billyau615/GE1354_Design_Project/README.md

# Automated Drug Dispenser

An automated drug dispensing system built with Micro:bit, ESP32, and a web-based management interface. The system monitors environmental conditions, controls servo-driven dispensing mechanisms, and communicates via MQTT.

## System Overview

| Component | Role |
|---|---|
| **Micro:bit #1** | Main logic — DHT20 sensor, OLED display, passive buzzer, DS3231 RTC, UART to ESP32, radio to MB2 |
| **Micro:bit #2** | Servo motor control — receives dispense commands from MB1 via radio |
| **ESP32** | WiFi connectivity and MQTT communication |
| **Web Server** | Python backend serving the management UI, bridging MQTT |
| **MQTT Server** | Message broker between ESP32 and web server |

## Repository Structure

```
├── experiments/           # Standalone test projects for individual components
│   ├── oled-dht20/
│   ├── buzzer-rickroll/
│   ├── ir-sensor/
│   ├── ntp-clock/
│   │   ├── microbit/
│   │   └── esp32/
│   └── ds3231/
│       ├── microbit/
│       └── esp32/
├── microbit/main/         # Micro:bit integrated code
│   ├── mb1/               # Micro:bit #1 (main logic)
│   └── mb2/               # Micro:bit #2 (servo control)
├── esp32/main/            # ESP32 Arduino firmware
├── server/                # Python web server + MQTT bridge
└── docs/                  # Project documentation
```

## Documentation

- [System Architecture](docs/architecture.md)
- [Hardware & Wiring](docs/hardware.md)
- [Main Project Design](docs/main-project.md) — protocols, features, config checklist
- [Progress Report](docs/progress-report.md)

### Component Guides

- [Micro:bit #1](docs/mb1.md) — boot sequence, OLED layout, dispensing, schedules, UART/radio protocol
- [Micro:bit #2](docs/mb2.md) — servo control, radio protocol, refill flow, calibration
- [ESP32](docs/esp32.md) — WiFi/NTP setup, MQTT topics, UART relay, NVS persistence
- [Web UI](docs/web-ui.md) — dashboard, schedules page, settings page, real-time polling
- [Python Backend](docs/backend.md) — Flask routes, MQTT bridge, Telegram alerts, data flow

## Main Code

| File | Description |
|---|---|
| [microbit/main/mb1/main.py](microbit/main/mb1/main.py) | Micro:bit #1 — main dispenser logic |
| [microbit/main/mb2/main.py](microbit/main/mb2/main.py) | Micro:bit #2 — servo actuator |
| [esp32/main/main.ino](esp32/main/main.ino) | ESP32 — WiFi + NTP + MQTT + UART bridge |
| [server/app.py](server/app.py) | Web server — Flask routes |
| [server/mqtt_bridge.py](server/mqtt_bridge.py) | MQTT background thread |
| [server/telegram.py](server/telegram.py) | Telegram alert helper |

## Experiments

Small test projects to validate individual components before integration:

| Experiment | Description |
|---|---|
| [oled-dht20](experiments/oled-dht20/) | Read DHT20 temperature/humidity and display on OLED |
| [buzzer-rickroll](experiments/buzzer-rickroll/) | Play "Never Gonna Give You Up" on a passive buzzer |
| [ntp-clock](experiments/ntp-clock/) | Sync time from ESP32 NTP and display datetime on OLED, beep every minute |
| [ir-sensor](experiments/ir-sensor/) | FC-51 IR obstacle sensor on P1 triggers buzzer on P0 |
| [ds3231](experiments/ds3231/) | Fetch NTP time from ESP32 via UART, write to DS3231 RTC, display time from RTC on OLED |
| [servo-test](experiments/servo-test/) | Calibrate JX BLS-HV7146MG servo for 4-slot rotary pill dispenser (MB2) |
| [servo-cal](experiments/servo-cal/) | MQTT-driven per-slot pulse width calibration for both wheels, no reflashing needed |

## Web UI Demo

Interactive demo of the full web interface — open [demo.html](demo.html) directly in a browser, no server required. Includes editable dummy values for storage, sensor readings, countdown, and device status.
