billyau615/GE1354_Design_Project/microbit/for submission/mb1/oled.py

# AI
from microbit import i2c

OLED_ADDR = 0x3C

FONT = bytearray([
    0x00,0x00,0x00,0x00,0x00, 0x00,0x00,0x5F,0x00,0x00, 0x00,0x07,0x00,0x07,0x00,
    0x14,0x7F,0x14,0x7F,0x14, 0x24,0x2A,0x7F,0x2A,0x12, 0x23,0x13,0x08,0x64,0x62,
    0x36,0x49,0x55,0x22,0x50, 0x00,0x05,0x03,0x00,0x00, 0x00,0x1C,0x22,0x41,0x00,
    0x00,0x41,0x22,0x1C,0x00, 0x08,0x2A,0x1C,0x2A,0x08, 0x08,0x08,0x3E,0x08,0x08,
    0x00,0x50,0x30,0x00,0x00, 0x08,0x08,0x08,0x08,0x08, 0x00,0x60,0x60,0x00,0x00,
    0x20,0x10,0x08,0x04,0x02, 0x3E,0x51,0x49,0x45,0x3E, 0x00,0x42,0x7F,0x40,0x00,
    0x42,0x61,0x51,0x49,0x46, 0x21,0x41,0x45,0x4B,0x31, 0x18,0x14,0x12,0x7F,0x10,
    0x27,0x45,0x45,0x45,0x39, 0x3C,0x4A,0x49,0x49,0x30, 0x01,0x71,0x09,0x05,0x03,
    0x36,0x49,0x49,0x49,0x36, 0x06,0x49,0x49,0x29,0x1E, 0x00,0x36,0x36,0x00,0x00,
    0x00,0x56,0x36,0x00,0x00, 0x00,0x08,0x14,0x22,0x41, 0x14,0x14,0x14,0x14,0x14,
    0x41,0x22,0x14,0x08,0x00, 0x02,0x01,0x51,0x09,0x06, 0x32,0x49,0x79,0x41,0x3E,
    0x7E,0x11,0x11,0x11,0x7E, 0x7F,0x49,0x49,0x49,0x36, 0x3E,0x41,0x41,0x41,0x22,
    0x7F,0x41,0x41,0x22,0x1C, 0x7F,0x49,0x49,0x49,0x41, 0x7F,0x09,0x09,0x01,0x01,
    0x3E,0x41,0x41,0x51,0x32, 0x7F,0x08,0x08,0x08,0x7F, 0x00,0x41,0x7F,0x41,0x00,
    0x20,0x40,0x41,0x3F,0x01, 0x7F,0x08,0x14,0x22,0x41, 0x7F,0x40,0x40,0x40,0x40,
    0x7F,0x02,0x04,0x02,0x7F, 0x7F,0x04,0x08,0x10,0x7F, 0x3E,0x41,0x41,0x41,0x3E,
    0x7F,0x09,0x09,0x09,0x06, 0x3E,0x41,0x51,0x21,0x5E, 0x7F,0x09,0x19,0x29,0x46,
    0x46,0x49,0x49,0x49,0x31, 0x01,0x01,0x7F,0x01,0x01, 0x3F,0x40,0x40,0x40,0x3F,
    0x1F,0x20,0x40,0x20,0x1F, 0x7F,0x20,0x18,0x20,0x7F, 0x63,0x14,0x08,0x14,0x63,
    0x03,0x04,0x78,0x04,0x03, 0x61,0x51,0x49,0x45,0x43, 0x00,0x00,0x7F,0x41,0x41,
    0x02,0x04,0x08,0x10,0x20, 0x41,0x41,0x7F,0x00,0x00, 0x04,0x02,0x01,0x02,0x04,
    0x40,0x40,0x40,0x40,0x40, 0x00,0x01,0x02,0x04,0x00, 0x20,0x54,0x54,0x54,0x78,
    0x7F,0x48,0x44,0x44,0x38, 0x38,0x44,0x44,0x44,0x20, 0x38,0x44,0x44,0x48,0x7F,
    0x38,0x54,0x54,0x54,0x18, 0x08,0x7E,0x09,0x01,0x02, 0x08,0x54,0x54,0x54,0x3C,
    0x7F,0x08,0x04,0x04,0x78, 0x00,0x44,0x7D,0x40,0x00, 0x20,0x40,0x44,0x3D,0x00,
    0x00,0x7F,0x10,0x28,0x44, 0x00,0x41,0x7F,0x40,0x00, 0x7C,0x04,0x78,0x04,0x78,
    0x7C,0x08,0x04,0x04,0x78, 0x38,0x44,0x44,0x44,0x38, 0x7C,0x14,0x14,0x14,0x08,
    0x08,0x14,0x14,0x14,0x7C, 0x7C,0x08,0x04,0x04,0x08, 0x48,0x54,0x54,0x54,0x20,
    0x04,0x3F,0x44,0x40,0x20, 0x3C,0x40,0x40,0x40,0x3C, 0x1C,0x20,0x40,0x20,0x1C,
    0x3C,0x40,0x30,0x40,0x3C, 0x44,0x28,0x10,0x28,0x44, 0x0C,0x50,0x50,0x50,0x3C,
    0x44,0x64,0x54,0x4C,0x44, 0x00,0x08,0x36,0x41,0x00, 0x00,0x00,0x7F,0x00,0x00,
    0x00,0x41,0x36,0x08,0x00, 0x08,0x08,0x2A,0x1C,0x08,
])

def _cmd(*cmds):
    i2c.write(OLED_ADDR, b'\x00' + bytes(cmds))

def init_oled():
    _cmd(0xAE)
    _cmd(0xD5, 0x80)
    _cmd(0xA8, 0x3F)
    _cmd(0xD3, 0x00)
    _cmd(0x40)
    _cmd(0x8D, 0x14)
    _cmd(0x20, 0x00)
    _cmd(0xA1)
    _cmd(0xC8)
    _cmd(0xDA, 0x12)
    _cmd(0x81, 0xCF)
    _cmd(0xD9, 0xF1)
    _cmd(0xDB, 0x40)
    _cmd(0x2E)
    _cmd(0xA4)
    _cmd(0xA6)
    _cmd(0xAF)

def clear_oled():
    chunk = b'\x40' + b'\x00' * 16
    for page in range(8):
        _cmd(0x22, page, page)
        _cmd(0x21, 0, 127)
        for _ in range(8):
            i2c.write(OLED_ADDR, chunk)

def _scale_nibble(nibble):
    result = 0
    for i in range(4):
        bit = (nibble >> i) & 1
        result |= (bit << (i * 2))
        result |= (bit << (i * 2 + 1))
    return result

def write_oled_large(text, start_page):
    top_data = bytearray(128)
    bot_data = bytearray(128)
    col = 0
    for char in text:
        if col + 10 > 128:
            break
        idx = ord(char) - 32
        if 0 <= idx < 95:
            for j in range(5):
                byte = FONT[idx * 5 + j]
                top = _scale_nibble(byte & 0x0F)
                bot = _scale_nibble((byte >> 4) & 0x0F)
                top_data[col + j * 2]     = top
                top_data[col + j * 2 + 1] = top
                bot_data[col + j * 2]     = bot
                bot_data[col + j * 2 + 1] = bot
        col += 12
    _cmd(0x22, start_page, start_page)
    _cmd(0x21, 0, 127)
    i2c.write(OLED_ADDR, b'\x40' + bytes(top_data))
    _cmd(0x22, start_page + 1, start_page + 1)
    _cmd(0x21, 0, 127)
    i2c.write(OLED_ADDR, b'\x40' + bytes(bot_data))

def write_oled(text, line):
    _cmd(0x22, line, line)
    _cmd(0x21, 0, 127)
    data = bytearray(128)
    col = 0
    for char in text:
        if col + 5 > 128:
            break
        idx = ord(char) - 32
        if 0 <= idx < 95:
            for j in range(5):
                data[col + j] = FONT[idx * 5 + j]
        col += 6
    i2c.write(OLED_ADDR, b'\x40' + bytes(data))
