billyau615/GE1354_Design_Project/experiments/ntp-clock/esp32/ntp_clock.ino

// NTP Clock — syncs time once on boot and sends HH:MM:SS to Micro:bit.
// Micro:bit then runs the clock independently.
//
// Wiring:
//   ESP32 GPIO17 (RX) ← Micro:bit P16 (TX)
//   ESP32 GPIO16 (TX) → Micro:bit P8  (RX)

#include <WiFi.h>
#include <time.h>

// ── User configuration ──────────────────────────────────────────────────────
const char* WIFI_SSID    = "YOUR_WIFI_SSID";
const char* WIFI_PASS    = "YOUR_WIFI_PASSWORD";
const char* NTP_SERVER   = "pool.ntp.org";
const long  GMT_OFFSET   = 8 * 3600;   // UTC+8 (Hong Kong)
const int   DST_OFFSET   = 0;

// ── Pin configuration ───────────────────────────────────────────────────────
#define MB_RX_PIN 17   // receives from Micro:bit P16
#define MB_TX_PIN 16   // sends to Micro:bit P8

void setup() {
    Serial.begin(115200);
    Serial1.begin(9600, SERIAL_8N1, MB_RX_PIN, MB_TX_PIN);

    Serial.print("Connecting to WiFi");
    WiFi.begin(WIFI_SSID, WIFI_PASS);
    while (WiFi.status() != WL_CONNECTED) {
        delay(500);
        Serial.print(".");
    }
    Serial.println(" connected");

    configTime(GMT_OFFSET, DST_OFFSET, NTP_SERVER);

    // Wait for NTP sync
    struct tm timeinfo;
    Serial.print("Syncing NTP");
    while (!getLocalTime(&timeinfo)) {
        delay(500);
        Serial.print(".");
    }
    Serial.println(" synced");

}

void loop() {
    // Keep sending time every second — Micro:bit takes the first valid line
    // and ignores the rest once its own clock is running
    struct tm timeinfo;
    if (!getLocalTime(&timeinfo)) {
        delay(1000);
        return;
    }

    char buf[9];
    strftime(buf, sizeof(buf), "%H:%M:%S", &timeinfo);
    Serial1.println(buf);
    Serial.println(buf);

    delay(1000);
}
