billyau615/GE1354_Design_Project/(commit log)

2026-03-29 Reorganize repo structure and add documentation
    - Move micro:bit experiments into microbit/experiments/ subfolders
    - Add system architecture and hardware docs
    - Add placeholder READMEs for esp32/ and server/
    - Rewrite README with project overview and repo structure guide
    - Add .gitignore for .DS_Store and .claude/
2026-03-29 Update architecture: UART for all inter-device comms, ESP32 is MQTT bridge only
2026-03-29 Fix bytearray slice assignment not supported in MicroPython
    [oled.py]
2026-03-29 Fix DHT20 bit extraction: use full 20-bit values, read 7 bytes
    [dht20.py]
2026-03-29 Add ntp-clock experiment: ESP32 NTP sync to Micro:bit OLED display
2026-03-29 Buzzer Rickroll Buzzer Pin Update
2026-03-29 Fix UART pins: ESP32 GPIO17(RX)/GPIO16(TX), update hardware docs
    [ntp_clock.ino]
2026-03-29 ntp-clock: ESP32 sends time once, Micro:bit runs clock independently
2026-03-29 ntp-clock: fix race condition, ESP32 sends time for 5s, Micro:bit validates line
    [main.py, ntp_clock.ino]
2026-03-29 ntp-clock: ESP32 sends time every second indefinitely, Micro:bit takes first valid line
2026-03-29 ntp-clock: fix UART read using uart.any()+read(1), drop blocking readline()
    [main.py, uart_test.py]
2026-03-30 Add ir-sensor experiment: FC-51 triggers buzzer on obstacle detection
    [main.py]
2026-03-30 Add main project: MB1 logic, ESP32 MQTT bridge, web server, MB2 stub
2026-03-30 Move all experiments to root experiments/ folder, delete esp32/README
2026-03-30 Fix folder nesting in esp32/main and correct broken README links
    [main.ino]
2026-03-30 Add real-time polling (5s) for storage and sensor; show modal on connection loss
2026-03-30 Integrate DS3231 RTC: driver, boot fast-path, 6h re-sync, experiment, hardware docs
2026-03-30 Add DS3231 RTC integration: experiment + main project refactor
    Experiment (experiments/ds3231/):
    - ESP32 sketch: connect WiFi, sync NTP, send TIME:HH:MM:SS via UART until ACK
    - Micro:bit: wait for NTP from ESP32 (30s timeout), write to DS3231, read and
    display time every second; show "No NTP signal" or "RTC Error" on failure
    - README with wiring tables, setup steps, boot sequence, error states, protocol
    Main project (microbit/main/mb1/):
    - ds3231.py: error return changed from (0,0,0) to (None,None,None) to cleanly
    distinguish RTC errors from midnight
    - main.py: drop software clock entirely in favour of reading DS3231 every second;
    boot always syncs DS3231 from ESP32 NTP; minute change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
    [ds3231.py, ds3231_ntp.ino, main.py]
2026-03-30 Update docs: DS3231 integration, fix file paths, remove Draft 1 labels
    progress-report.md:
    - Remove "Draft 1" from 30 Mar subheading
    - Add DS3231 experiment entry and hardware validated row
    - Update MB1 description: NTP syncs DS3231 on boot, reads RTC every second (no software clock)
    - Fix ESP32 file path (esp32/main/main.ino, not esp32/main/main/main.ino)
    - Remove "NTP re-sync" from Up Next (now handled by DS3231 on every boot)
    - Add 5s real-time polling detail to web server description
    main-project.md:
    - Remove "Draft 1" label, replace with "Last updated"
    - Fix file structure: mb1/ and mb2/ subfolders, ds3231.py listed, esp32/main/ path
    - Fix config checklist: esp32/main/main.ino (not esp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
2026-03-30 Update architecture.md and README: DS3231, radio comms, MQTT topics
    architecture.md:
    - Add DS3231 RTC to MB1 component list and diagram
    - Fix MB1↔MB2 communication: UART → radio (built-in 2.4GHz, group 42)
    - Fix dispense command flow: UART → Micro:bit #2 → radio
    - Replace "Topic structure: TBD" with actual topic list
    README:
    - Update system overview table: MB1 now lists DS3231 and radio; MB2 notes radio
2026-03-30 Update progress report: replace DS3231 RTC validation with FC-51 IR obstacle sensor
2026-03-30 MB2: display received radio commands on LED matrix pending servo hardware
    Instead of a silent stub, MB2 now scrolls the command type (A/B/AB) on
    the LED matrix and shows an arrow for SERVO_STEP, then replies DONE: so
    the full radio round-trip can be tested before servos arrive.
    Update docs to reflect this in Known Limitations and Up Next.
2026-03-31 Flip time-sync handshake: Micro:bit requests time, ESP32 responds
    Previously ESP32 sent TIME: on boot unprompted. Now:
    - Micro:bit sends TIME_REQ after UART init
    - ESP32 waits for TIME_REQ before starting the TIME: broadcast
    - ESP32 stops broadcasting after receiving TIME_ACK
    Updated: mb1/main.py, esp32/main/main.ino, experiment microbit/main.py,
    experiment ds3231_ntp.ino, docs/main-project.md, experiment README.
    Also blanked WiFi credentials accidentally left in experiment sketch.
    [ds3231_ntp.ino, main.ino, main.py]
2026-03-31 Add MQTT username/password authentication support
    ESP32: add MQTT_USER and MQTT_PASS config constants, pass to both
    connect() and reconnect() calls.
    Server: mqtt_bridge.start() accepts broker_user/broker_pass; calls
    username_pw_set() before connecting. app.py forwards argv[2]/argv[3]
    as credentials.
    Usage: python app.py <host> <user> <pass>
    Docs: update config checklist and running instructions.
    [main.ino]
2026-03-31 Align dashboard UI with preview: cards, section titles, sensor colors, navbar
2026-03-31 Fix type inference warning in compute_countdown: explicit int() cast on DS3231 values
    [main.py]
2026-03-31 Revert int() cast — Thonny linter false positives, code is correct at runtime
    [main.py]
2026-03-31 Add uart-test experiment: PING/PONG to diagnose UART wiring
2026-03-31 Resend TIME_REQ every 2s until TIME: received
    Micro:bit was sending TIME_REQ once on boot, but ESP32 takes several
    seconds to connect WiFi and sync NTP. By the time ESP32 was ready,
    the request was already gone. Now both experiment and main project
    resend TIME_REQ every 2 seconds until a valid TIME: reply arrives.
2026-03-31 5 UI and UX fixes
    OLED:
    - Add write_oled_large() (2x scale, 12px/char, 2 pages tall) to oled.py
    - update_oled() uses 2x scale: time (pages 0-1), humidity (2-3),
    temperature (4-5), countdown (6-7)
    - compute_countdown() format changed to '3H 25M'
    Web UI:
    - Add white-space:nowrap to .sensor-val so temp/humidity never wraps
    - Add /api/countdown endpoint to app.py
    - Countdown badge updated every 5s via poll(); hides when no schedules
    Schedules:
    - ESP32 sends SCHED: (empty) when schedule array is cleared so MB1
    clears its local schedule list immediately
    [main.ino, main.py, oled.py]
2026-03-31 Strip comments from MB1 files to reduce source size (20KB → 15KB)
    Web editor rejects builds over ~8KB. Use Thonny to flash instead —
    copy all four .py files to the Micro:bit filesystem via View > Files.
2026-03-31 MB1: OLED dispense screen, NGGYU+IR wait, countdown format fix
    - Dispense: OLED shows 'Take meds / A|B|A+B / HH:MM', plays Never Gonna
    Give You Up on loop until IR sensor (pin1) detects hand
    - Countdown: format changed to 'Next: xH xxM'; skips delta==0 so
    display shows next future schedule immediately after dispensing
    instead of '0H 00M'; uses small font to fit full string
    [main.py]
2026-03-31 Add manual dispense mode; fix OLED font size, time format, schedule reliability
    MB1:
    - Add do_dispense_manual(): drops pills silently (no buzzer/OLED/IR wait)
    - Handle MANUAL: UART command in parse_uart_line
    - OLED time now shows HH:MM AM/PM (12-hour, no seconds)
    - Countdown uses write_oled_large (same size as other rows), format Nx:xH xxM
    - check_schedules() called every loop second (not just on minute change)
    so skipped DS3231 reads can't miss a scheduled dispense
    ESP32: handle action='manual' -> send MANUAL:<type> over UART
    Server:
    - /dispense accepts mode field: 'normal' -> action=dispense, 'manual' -> action=manual
    - Dashboard: storage cards show count only; new Dispense section wit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
    [main.ino, main.py]
2026-03-31 Update docs for 31 March changes
    - main-project.md: UART/MQTT tables (MANUAL: command), OLED layout,
    two dispense modes, schedule reliability, server binding
    - progress-report.md: add 31 March section
2026-03-31 Add detailed component docs: mb1, esp32, web-ui, backend
2026-03-31 MB1: fix refill confirm screen dismissed immediately on long-press release
    was_pressed() returned True instantly from the long-press release event.
    Now waits for both buttons to be physically released, then drains
    was_pressed() state before entering the confirm loop.
    [main.py]
2026-04-01 4 fixes: storage persistence, OLED time format, storage timestamp, device status
    - mqtt_bridge: fix state.json load key mismatch (storage_a/b -> a/b);
    storage was always restoring to 7/7 after server restart
    - MB1: OLED time no leading zero for single-digit hours (1:45 PM not 01:45 PM)
    - Storage section: show last update date+time (DD/MM HH:MM); larger font 3.2rem
    - Dashboard: new Device section shows online/offline (green/red dot) + IP address;
    polled every 5s alongside other data; ESP32 adds WiFi IP to sensor MQTT payload
    - /api/status endpoint: online if sensor received within 90s
    [main.ino, main.py]
2026-04-01 Update docs for 4 fixes: OLED time, device status, storage timestamp, storage persistence
2026-04-01 Dashboard: faster offline detection, 15s sensor, sensor timestamp, offline placeholders
    - ESP32 publishes dispenser/ping every 5s; server detects offline within 15s
    (replaces 90s sensor-based detection; max browser latency ~20s, no reload needed)
    - DHT20 sensor interval 30s -> 15s (MB1 sensor_timer and reset)
    - Sensor timestamp format changed to 'Mmm DD, YYYY HH:MM' (e.g. Apr 01, 2026 14:32)
    with larger font on dashboard (small -> span 0.9rem)
    - Storage last-updated timestamp removed from dashboard
    - When device offline: storage shows '- / 7' with grey bar, sensor shows '-'
    [main.ino, main.py]
2026-04-01 3 fixes: sensor timestamp style/format, hide IP offline, storage persistence
    - Sensor timestamp: font capped at 0.75rem (matches section title), lighter
    color (#9ca3af), 'Last updated:' prefix restored, seconds included
    - IP address hidden when device is offline
    - Storage count no longer resets to 7/7 on device reboot: removed MQTT
    publish from push_init_to_mb() so ESP32 NVS defaults cannot overwrite
    server's state.json — server state.json is now the sole source of truth
    [main.ino]
2026-04-01 MB2: servo control for JX BLS-HV7146MG dispensers
2026-04-01 Experiment: MB2 servo calibration for 8-slot rotary dispenser
2026-04-01 Move servo-test experiment to root experiments folder
2026-04-01 servo-test: fix HOME_US to 1500 midpoint to avoid servo non-linearity
    [main.py]
2026-04-01 servo-test: keep PWM on after move to stop servo shaking
2026-04-01 servo-test: ratchet-style dispense (home -> push -> home)
2026-04-01 servo-test: fix Button B nudge logic, larger 50us step
    [main.py]
2026-04-01 servo-test: calibrated HOME_US=1400 STEP_US=500, add dispense counter
2026-04-01 servo-test: rewrite for continuous rotation servo, 2-phase calibration
2026-04-01 servo-test: simplify to bare minimum for continuous rotation servo
2026-04-01 servo-test: 180deg servo, home at 0deg, 5 slots across full range
2026-04-01 servo-test: phase 1 find true max range, phase 2 5-slot test
2026-04-01 servo-test: slots 1-5, 4 intervals, fine-tune step size in phase 2
2026-04-01 servo-test: slots 0-5, home at 0, 5 physical slots
2026-04-01 servo-test: reverse direction, home at rightmost (MAX_US)
    [main.py]
2026-04-01 servo-test: home at HOME_US, slots 1-5 advance rightward
2026-04-01 servo-test: 3-phase calibration, find home and max before testing slots
2026-04-01 servo-test: fresh start, find min/max positions
2026-04-01 servo-test: home=500us, 5 steps to 2000us, 300us per step
2026-04-01 servo-test: 4 steps, slot 0=500us to slot 4=2000us
2026-04-01 servo-test: slot 4 at true 180deg (2500us), 500us per step
2026-04-01 docs: servo calibration values for both JX BLS-HV7146MG servos
2026-04-01 docs: servo-test README, progress report 1 Apr
2026-04-01 README: add servo-test experiment to experiments table
2026-04-01 MB2 servo integration; 4-pill capacity throughout; refill via servo steps
    - MB2 rewrite: HOME_US=500, STEP_US=500, 4 slots; no home on startup;
    handles INIT:a,b (restore position), DISPENSE:A/B/AB, REFILL:A/B,
    SERVO_STEP:A/B
    - MB1: storage defaults 7→4, refill cap 7→4; sends INIT:a,b after boot
    STORAGE_SET; sends REFILL:X before count loop and SERVO_STEP:X per
    button press in refill mode (loads pills through dispense hole)
    - Dashboard: storage /7→/4, low warning ≤2→≤1, offline shows - /4
    - Schedules: per-type limit of 4 (not global 6); shows X/4 counters;
    type selector hides types at max
    - ESP32 NVS defaults: storage_a/b 7→4
    - mqtt_bridge: in-memory default 7→4
    - Do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
2026-04-01 Fix 5 inconsistencies found in review: storage defaults 7→4 in mqtt_bridge/ESP32, sensor timer doc 30→15s, schedule doc 6→per-type-4, buzzer qty 2→1
    [main.ino]
2026-04-01 Update hardware.md and progress-report: 2 buzzers same pin, web editor works, 1 Apr servo 180° discovery narrative, 2 Apr reframed around 180° constraint
2026-04-01 Remove stale stub/deferred references; fix storage examples 7→4 in docs; update CLAUDE.md
2026-04-01 Update architecture.md: add IR sensor, servo details, ping topic, all comm flows
2026-04-01 Update known limitations section in main-project.md
    Clarified the status of servo control in known limitations.
2026-04-01 Update last updated date in esp32.md
    Updated the last updated date in the documentation.
2026-04-02 MB2: remove manual button testing; update mb2.md
2026-04-02 Fix MB1 storage mismatch: push authoritative storage to MB1 when ESP32 comes online
2026-04-02 MB2: show X when dispense skipped (slot at max), arrow only on actual move
    [main.py]
2026-04-02 MB1: send INIT to MB2 after refill to reset slot position
    [main.py]
2026-04-02 Fix slot direction (full=slot4, dispense decrements); add main loop error recovery in MB1
    [main.py]
2026-04-02 MB1: wait for button release before starting refill loop to prevent spurious slot advance
    [main.py]
2026-04-02 Docs: update mb1, mb2, backend for slot direction fix, refill button fix, INIT resend, storage sync on reconnect
2026-04-02 Add servo-cal experiment: MQTT-driven pulse width calibration for both wheels
2026-04-02 Add README for servo-cal experiment
2026-04-02 README: add servo-cal experiment to experiments table
2026-04-02 Add servo calibration values for Wheel A and B
    Updated the servo calibration table with specific us values for each wheel slot.
2026-04-02 MB2: replace uniform step with calibrated per-slot lookup tables for both wheels
    [main.py]
2026-04-02 Update progress report: 2 Apr — servo integration, calibration, bug fixes, demo.html, servo-cal experiment
2026-04-02 Fix sensor value overflow when humidity is 100%: use clamp font-size
2026-04-08 Minor formatting fixes in MB2 main.py; add For Submission folder
    [main.py]
2026-04-11 Add comments to clarify UART reading and dispensing logic in main.py and all_in_one.txt
